JulioHermenegildo/Smart-Energy-System/Page 1.png

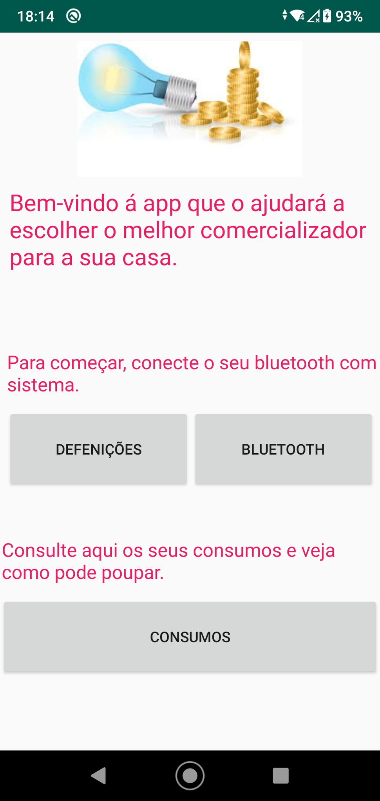
Page 1.png
