JulioHermenegildo/Smart-Energy-System/Page 1_2.png

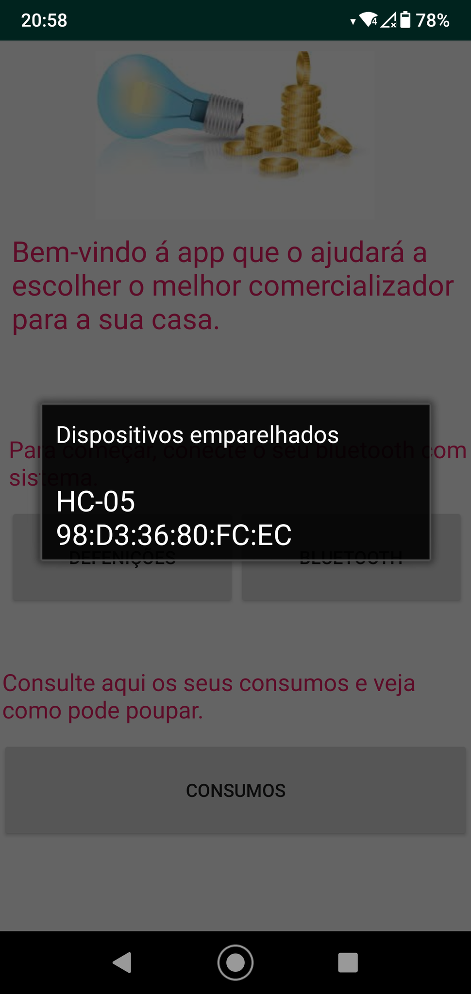
Page 1_2.png
