JulioHermenegildo/Smart-Energy-System/Page 2.png

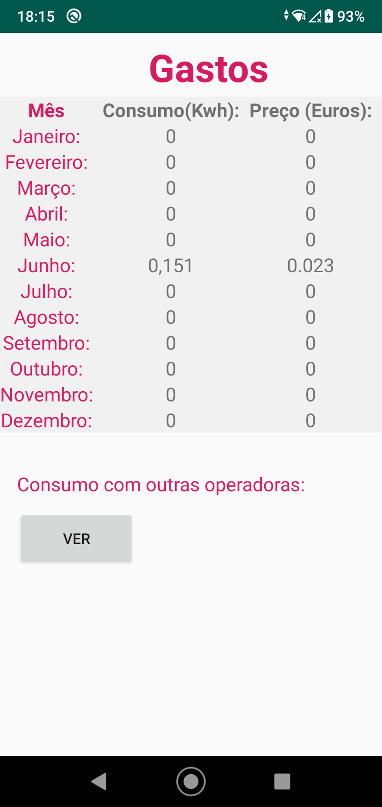
Page 2.png
