JulioHermenegildo/Smart-Energy-System/Page 2_2.png

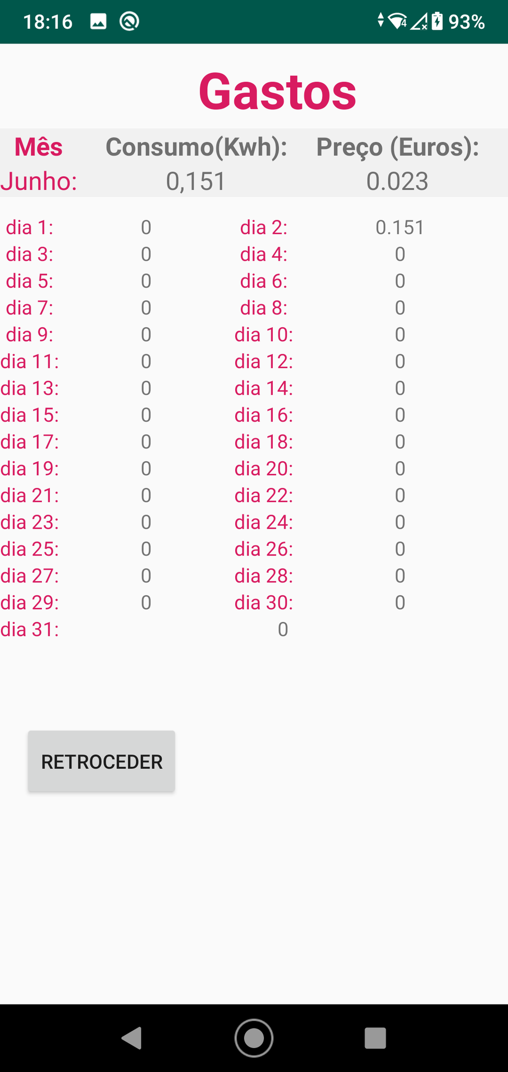
Page 2_2.png
