JulioHermenegildo/Smart-Energy-System/Page 3.png

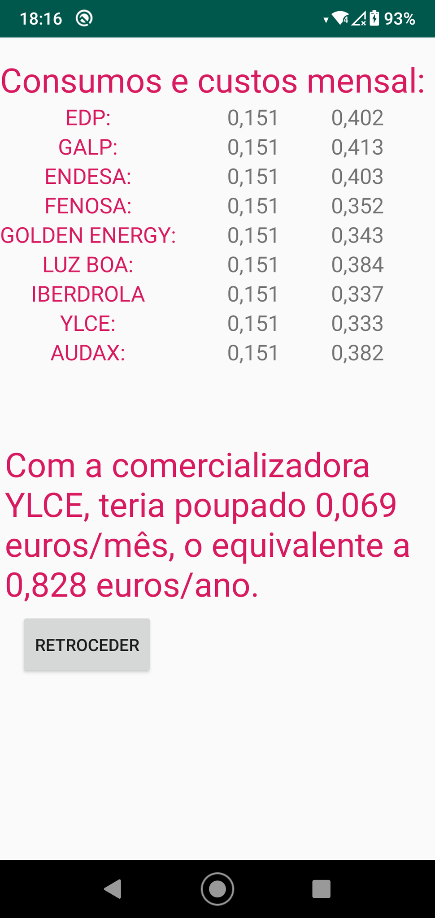
Page 3.png
